UVicFormulaMotorsport/PDU/README.md

# PDU

The UVic Formula Motorsports Power Distribution Unit (PDU) replaces traditional
fuses and relays with solid state drivers switched and monitored by a
microcontroller. The PDU is intended to distribute power to all of the car's
electrical systems.
