UVicFormulaMotorsport/PDU/hardware/design/PDU-UV17.PcbDoc.htm

Reporting Options

# File in Previous Format

Date | : | 2021-09-23
Time | : | 09:46:36 AM
Filename | : | C:\Users\PC\Documents\GitHub\PDU\hardware\design\PDU-UV17.PcbDoc

Version | Warning

This file was generated by an earlier version of the software
