UVicFormulaMotorsport/PDU/hardware/release/UV17-B/PDU-Schematics-UV17-B.PDF

## Title Sheet

PDUv17: Power Distribution Unit | Revision: B
Date: 2017-02-21 | Sheet: 1/ 11

# PDUv17

# Power Distribution Unit

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
## Title.SchDoc Power.SchDoc Microcontroller.SchDoc Drivers - Low Current.SchDoc Drivers - High Current.SchDoc Multiplexers.SchDoc Serial IO.SchDoc Peripherals.SchDoc Inputs.SchDoc Connectors.SchDoc Mecahnical.SchDoc

## Fancy title sheet Power supplies AT90CAN automotive microcontroller Low current high side drivers High current high side drivers Analog multiplexers Serial IO expanders Peripherals: CAN, temperature sensors Digital and analog inputs Connectors Mechanical components and details

File Name | Page | Description
Revision | Date | Remarks

A
B

2017-02-17
2017-02-21

## Initial revision Added digital input pull-ups, analog and digital input clamping diodes

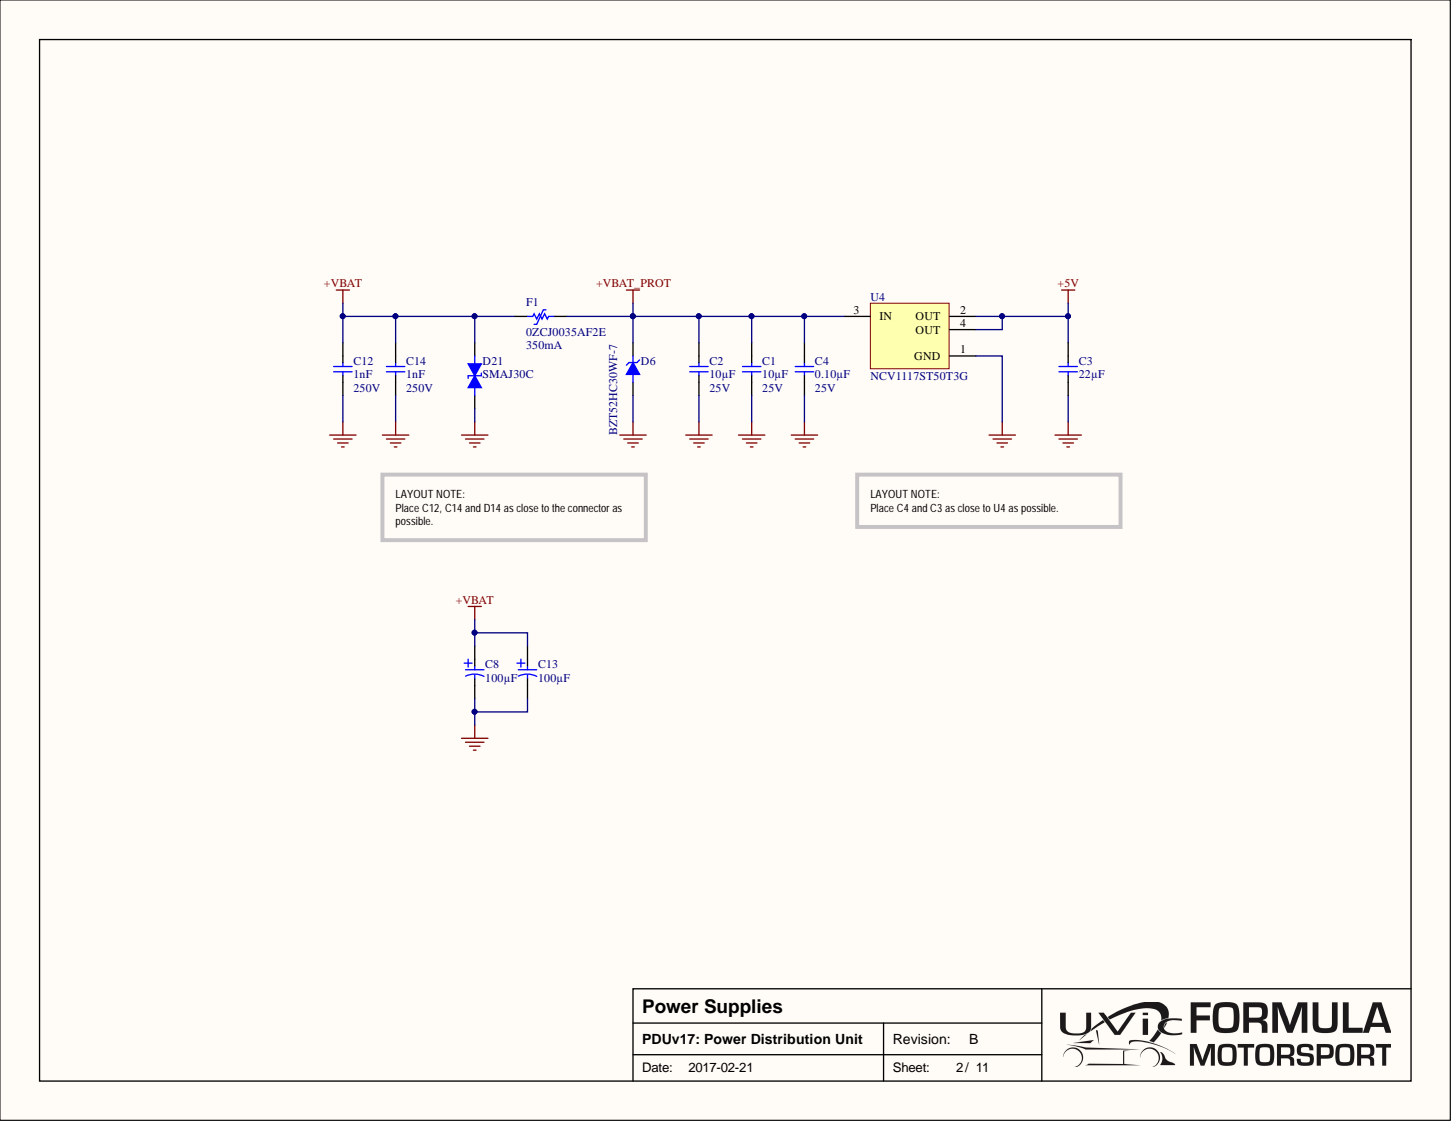
[picture p1: page 2]

LAYOUT NOTE:
Place C12, C14 and D14 as close to the connector as
possible.

Place C4 and C3 as close to U4 as possible.

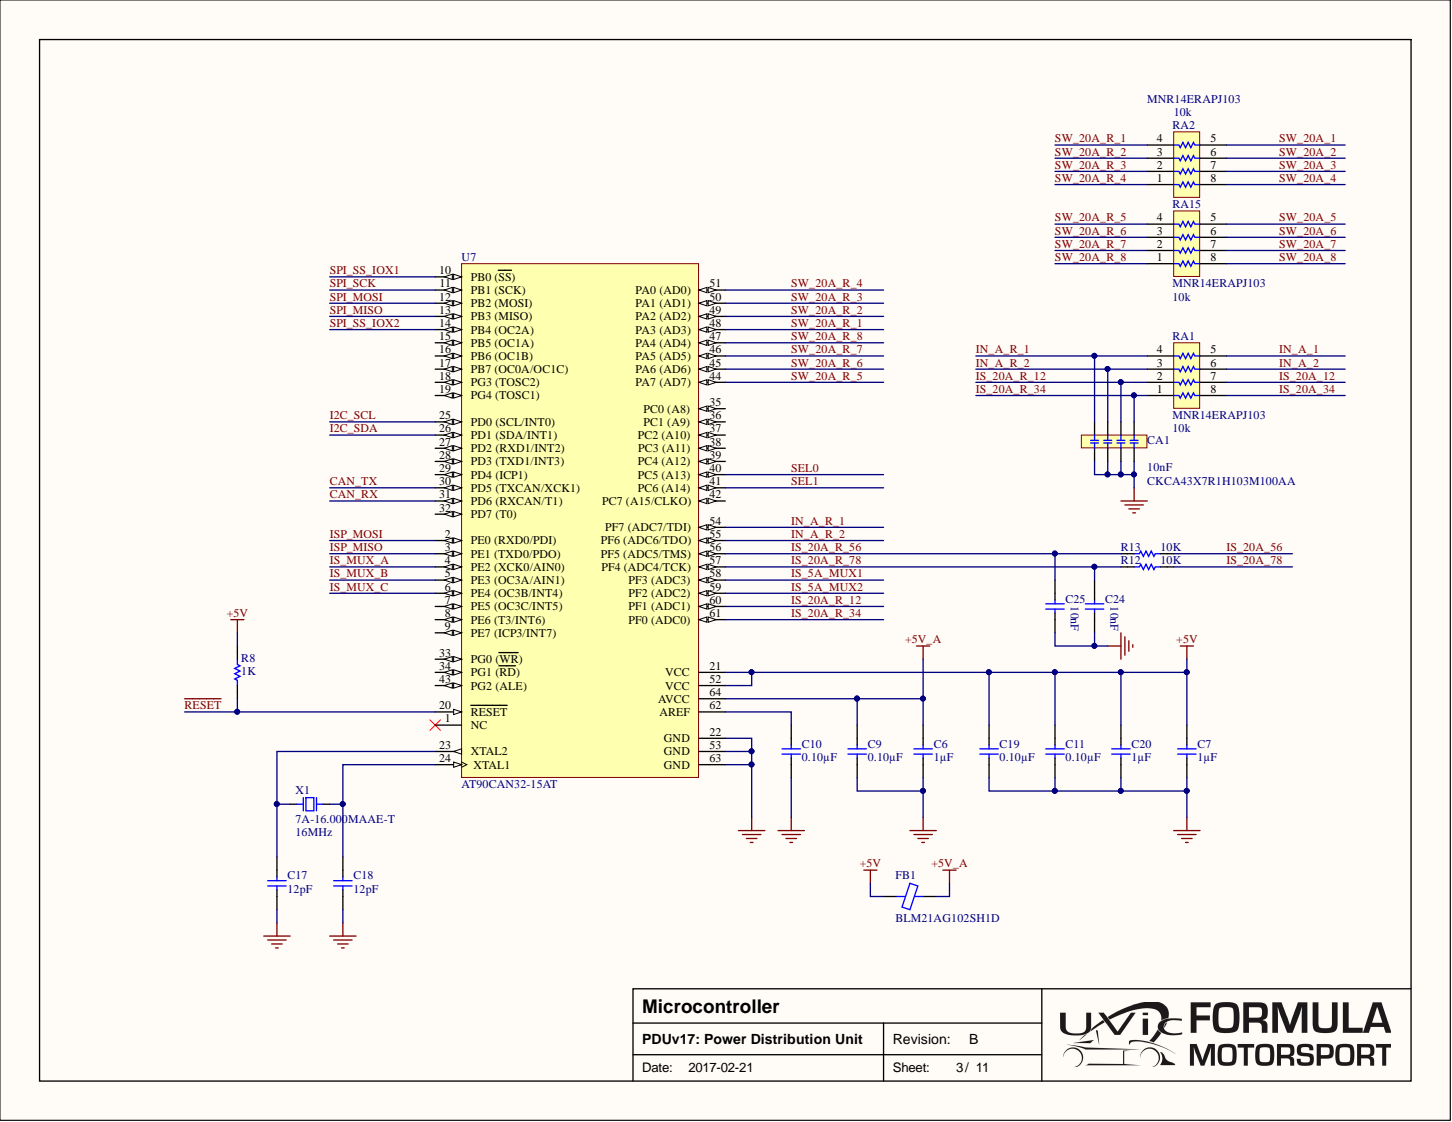
[picture p2: page 3]

2 2
5 3

u tio n Unit | Revision: B

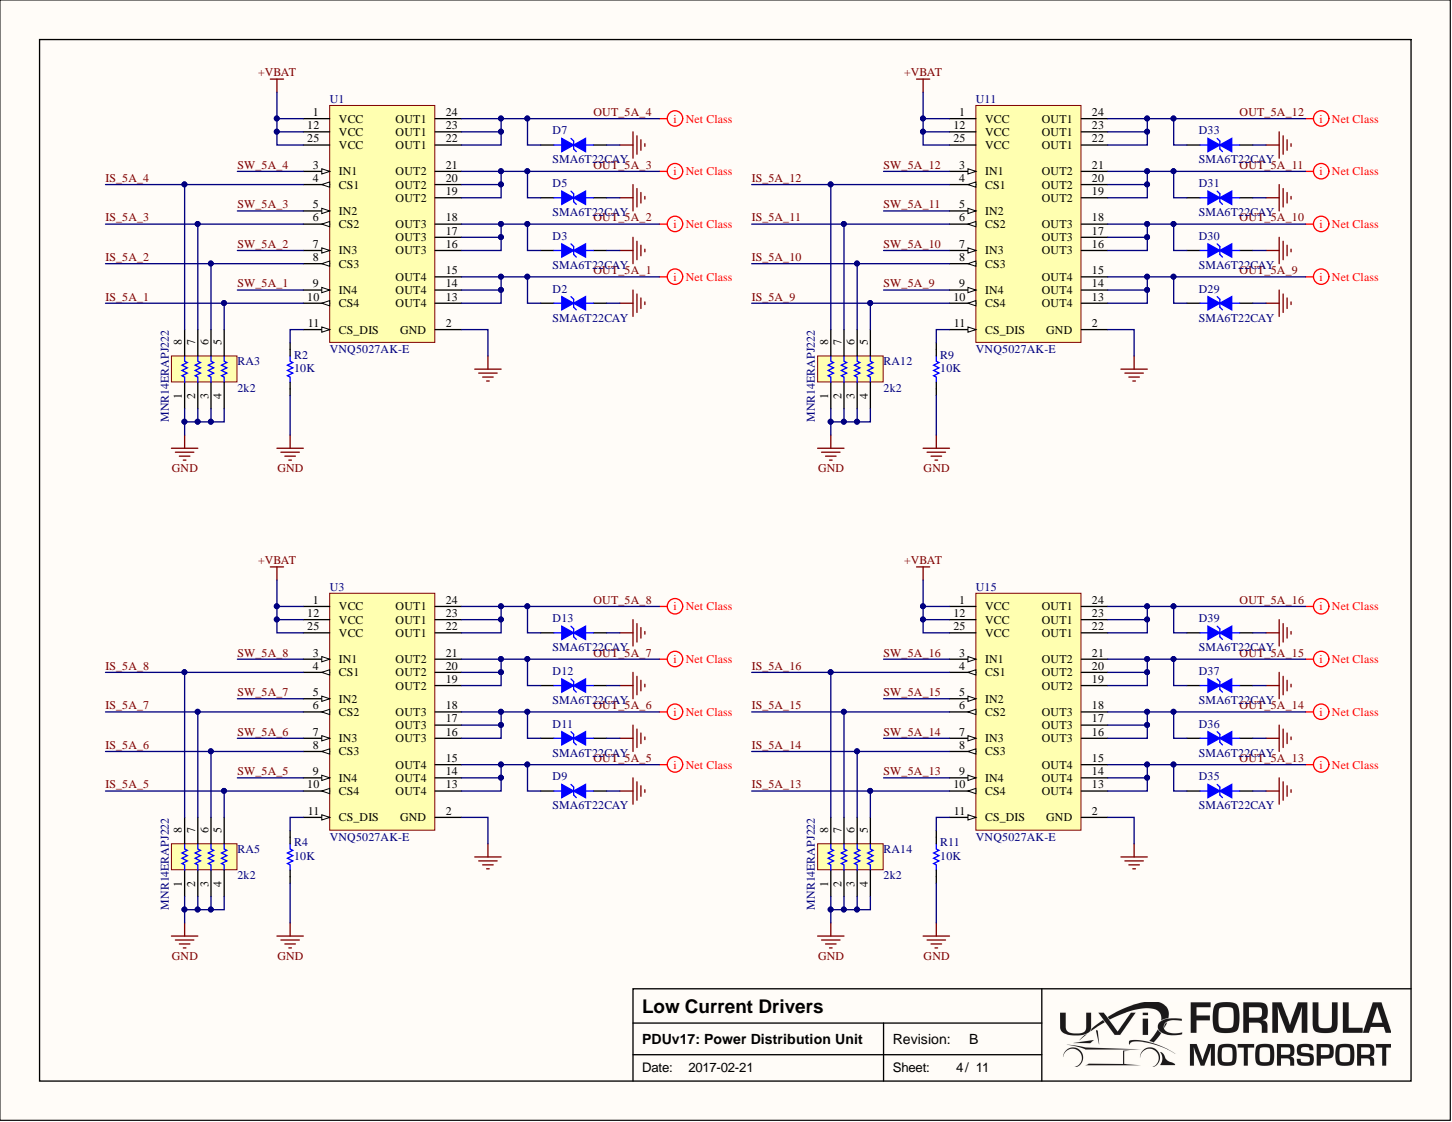
[picture p3: page 4]

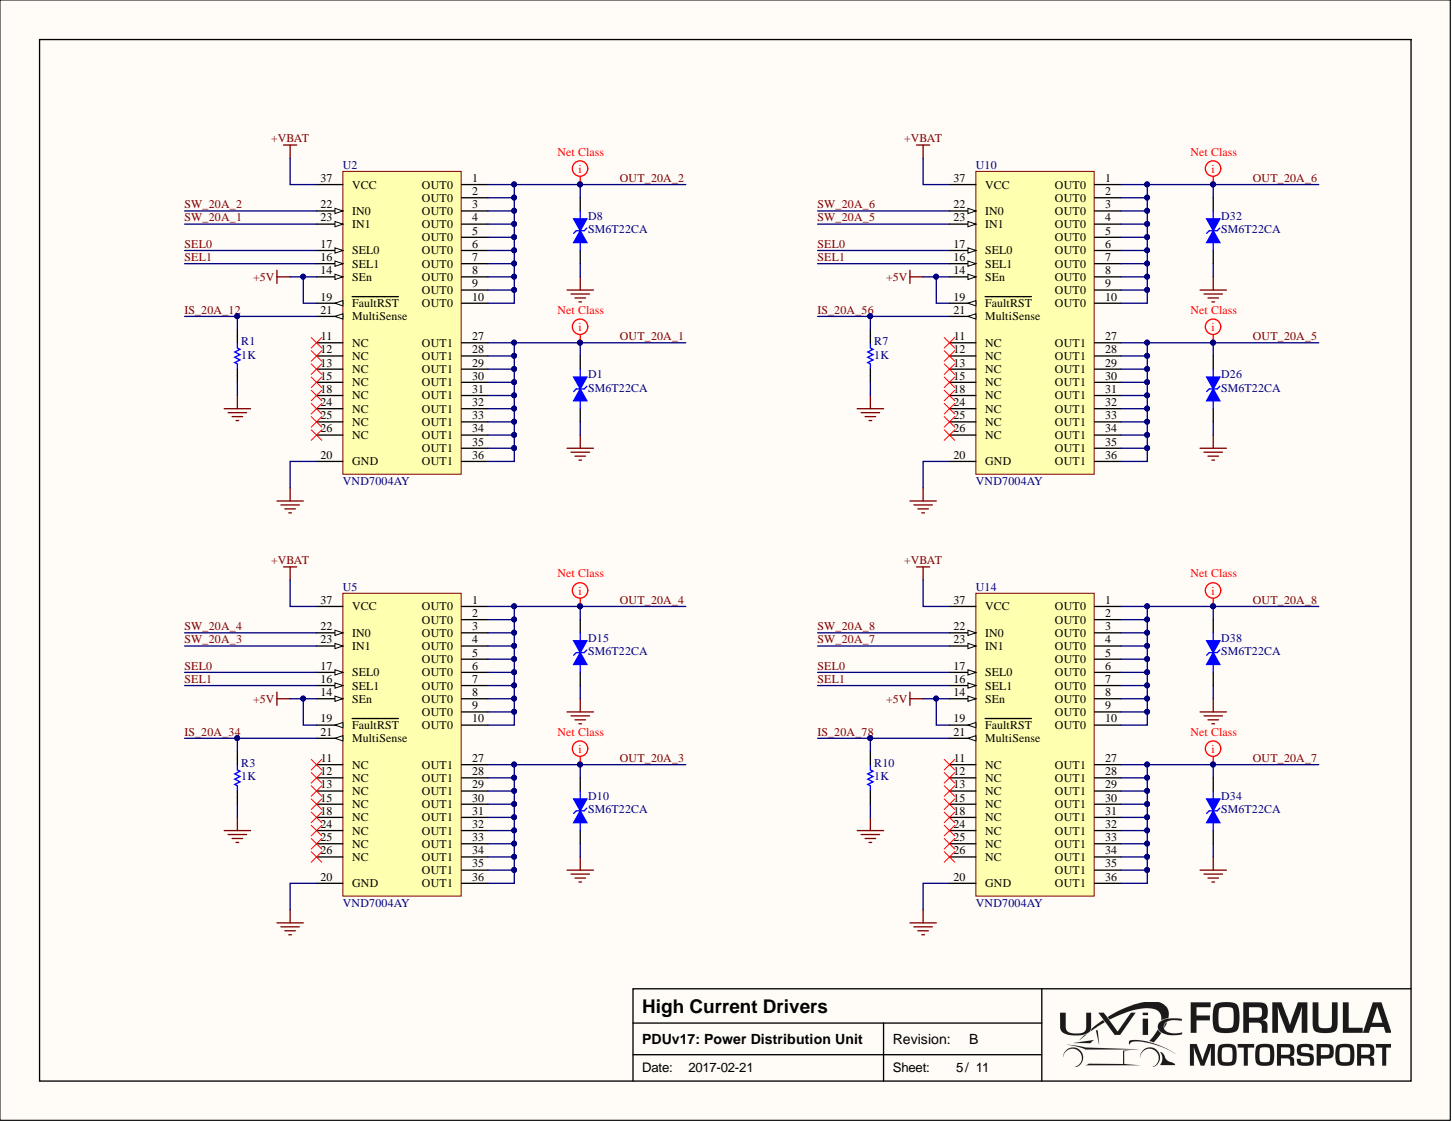
[picture p4: page 5]

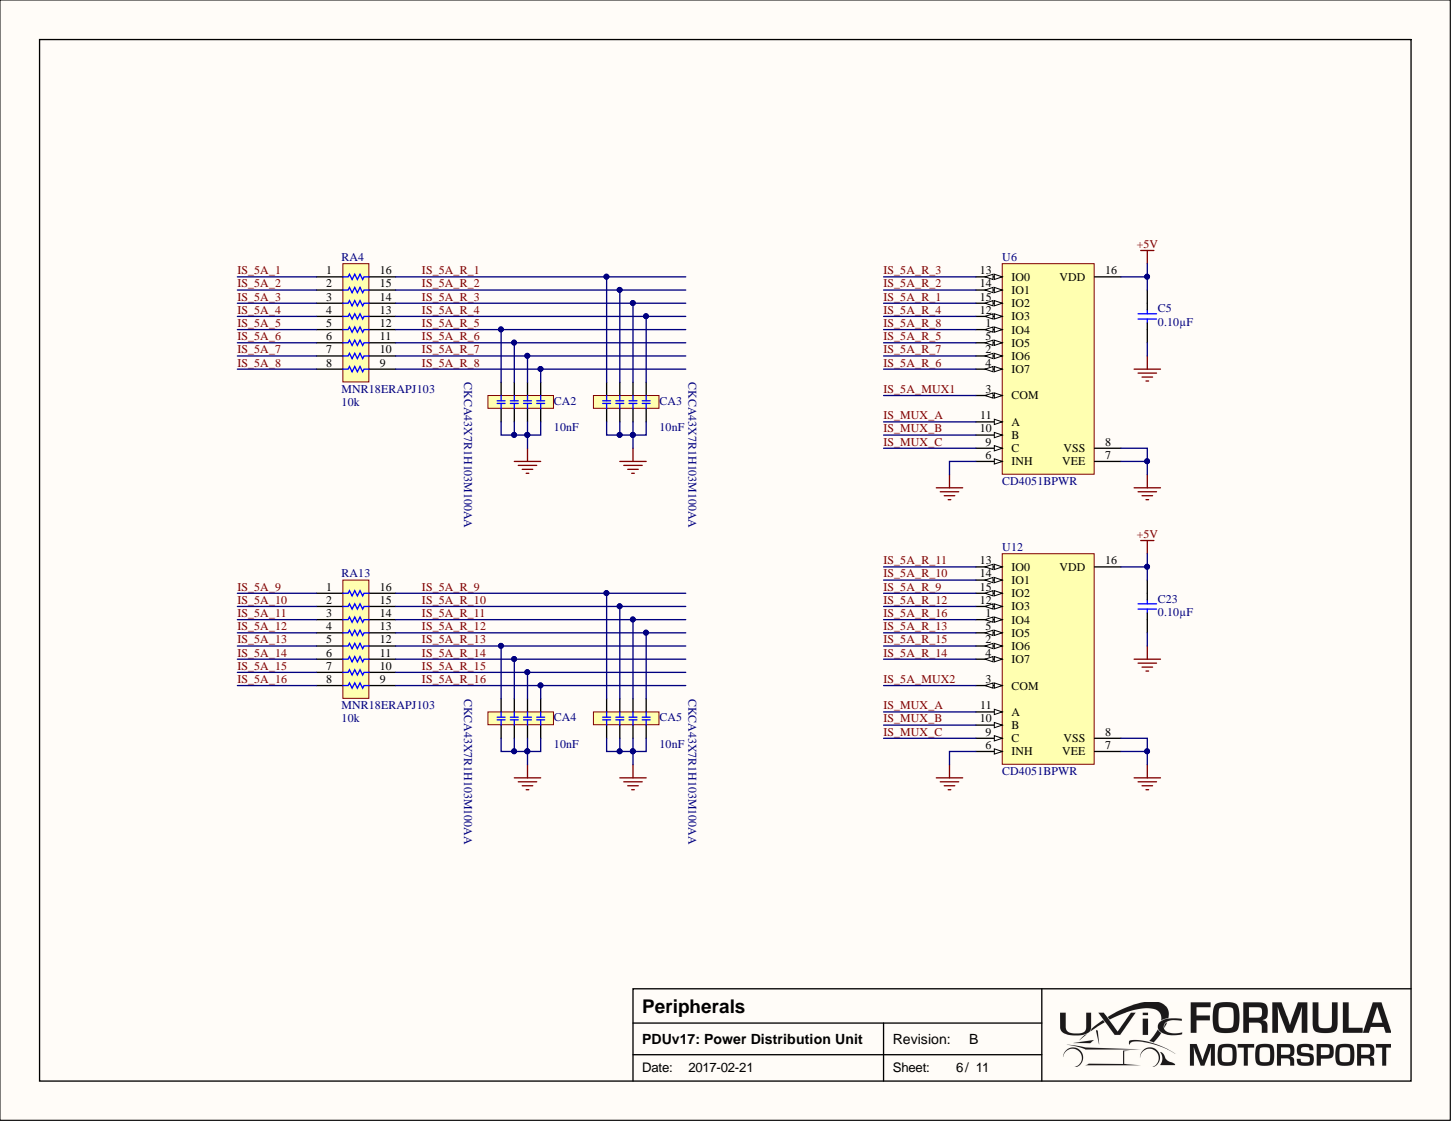
[picture p5: page 6]

rib u tio n Unit

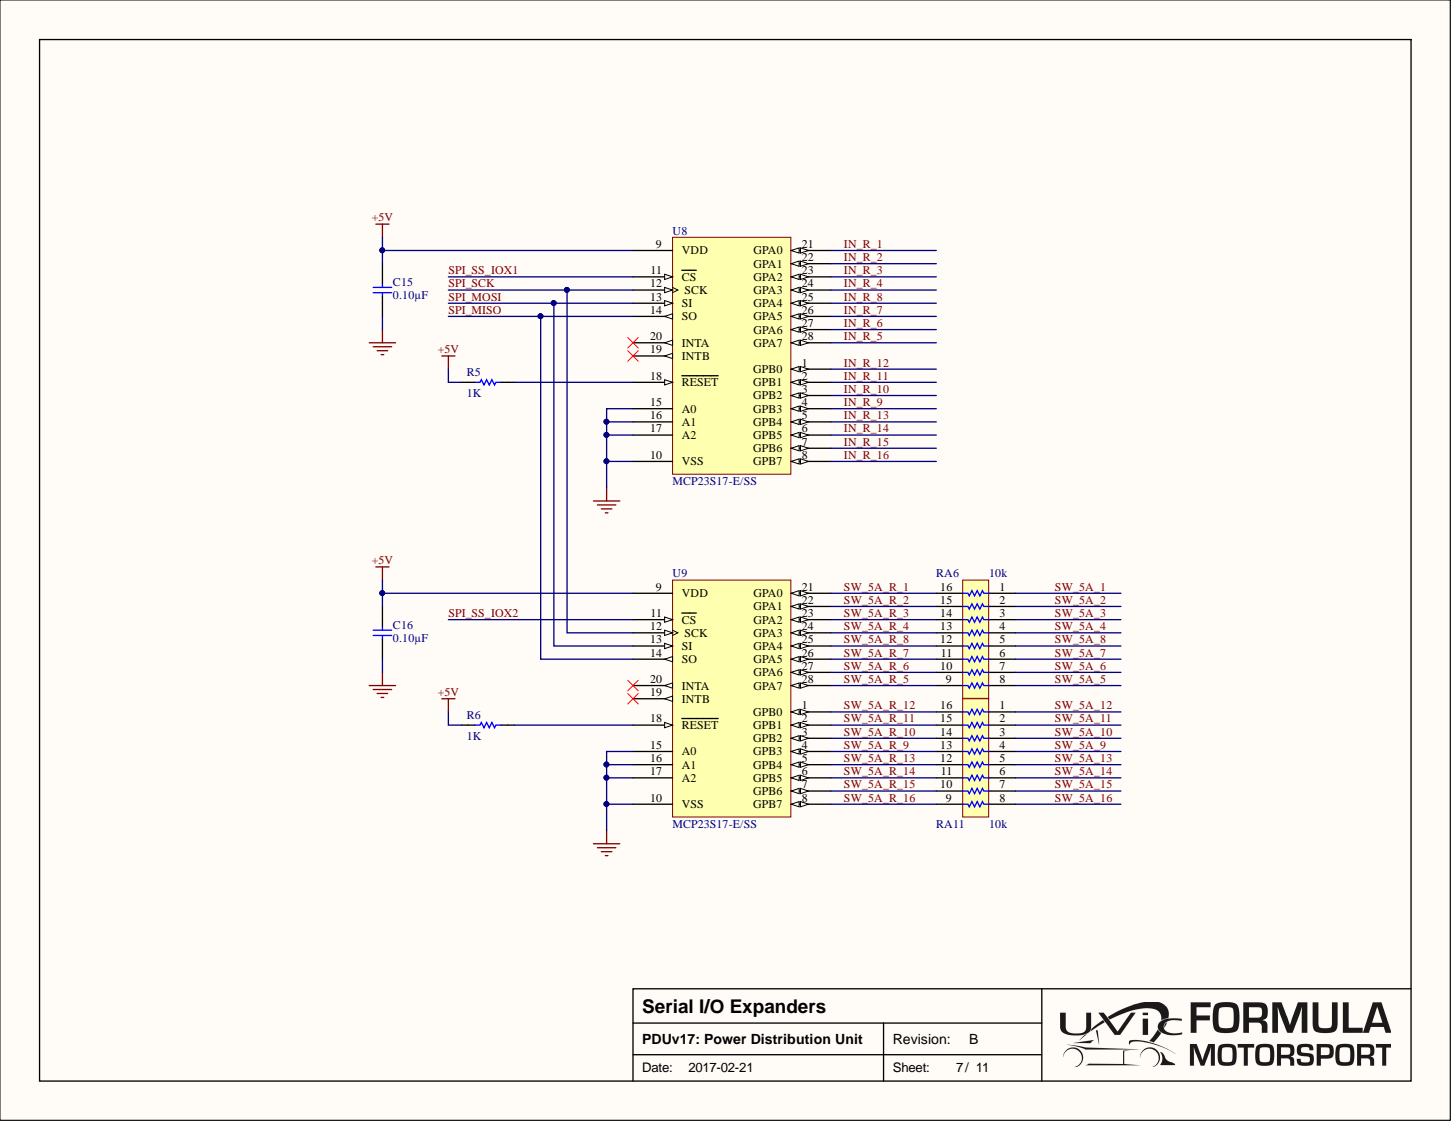
[picture p6: page 7]

1 6
1 7

1 2 | 2 4 SW _ 5 A _R_ 4 1 3
1 3 | 2 5 SW _ 5 A _R_ 8 1 2
1 4 | 2 6 SW _ 5 A _R_ 7 1 1

1 6 | 5 SW _ 5 A _R_ 1 3 1 2
1 7 | 6 SW _ 5 A _R_ 1 4 1 1
1 0 | 7 SW _ 5 A _R_ 1 5 1 0

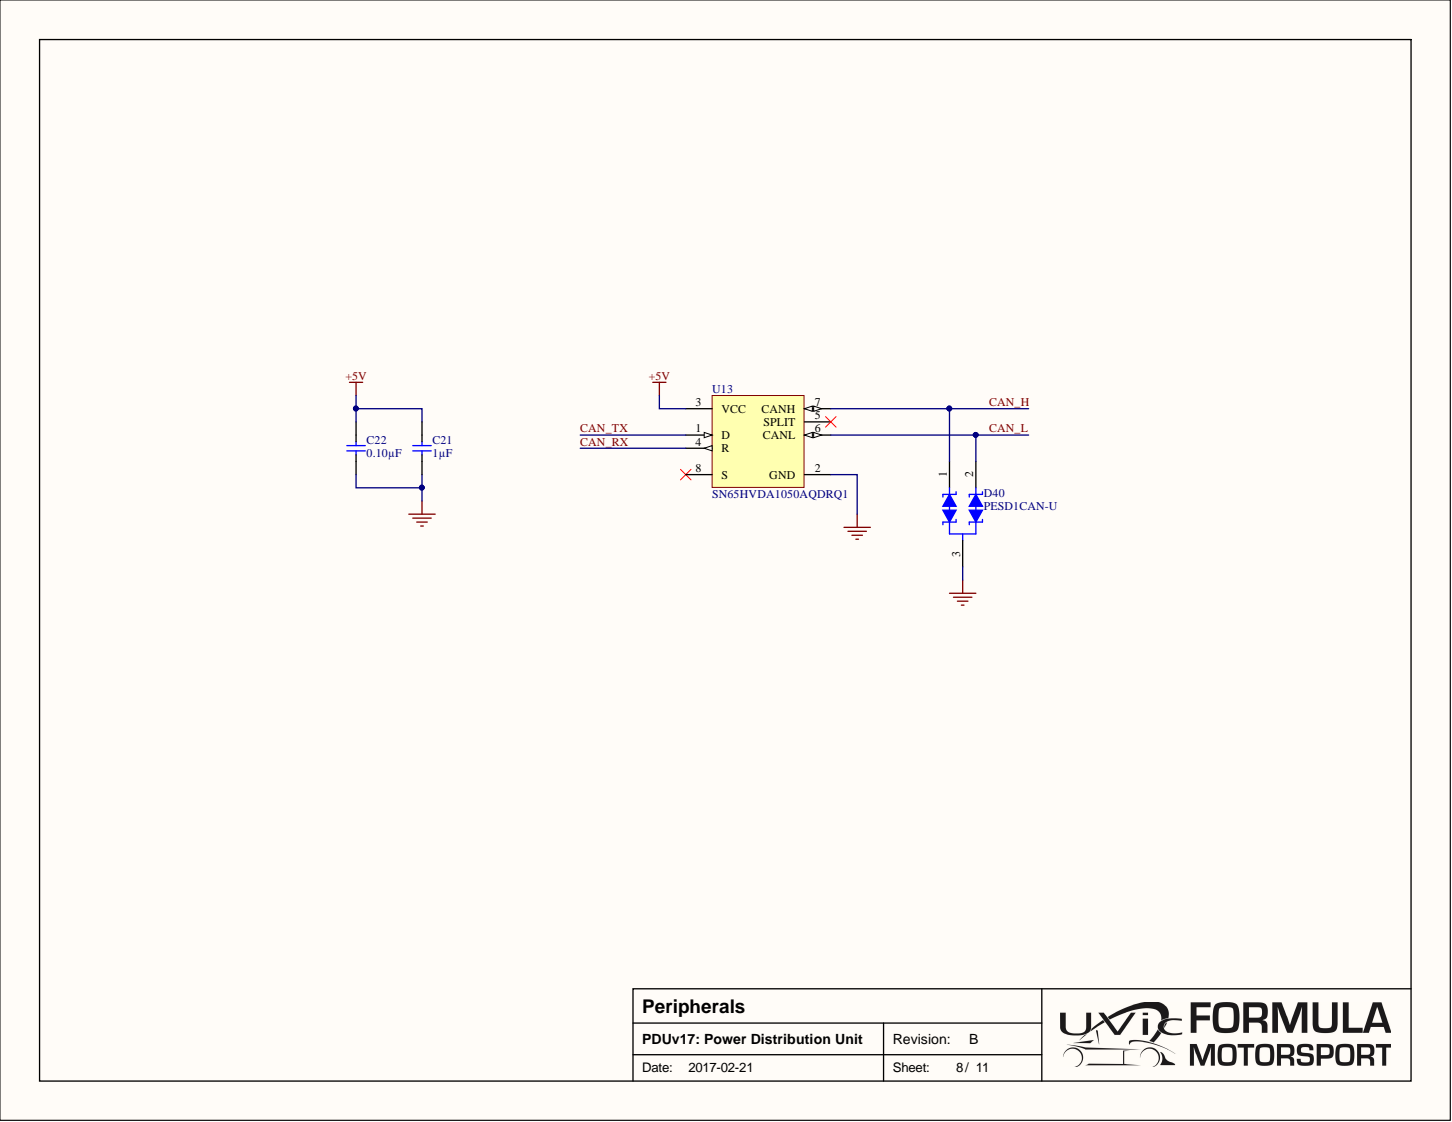
[picture p7: page 8]

rib u tio n Unit

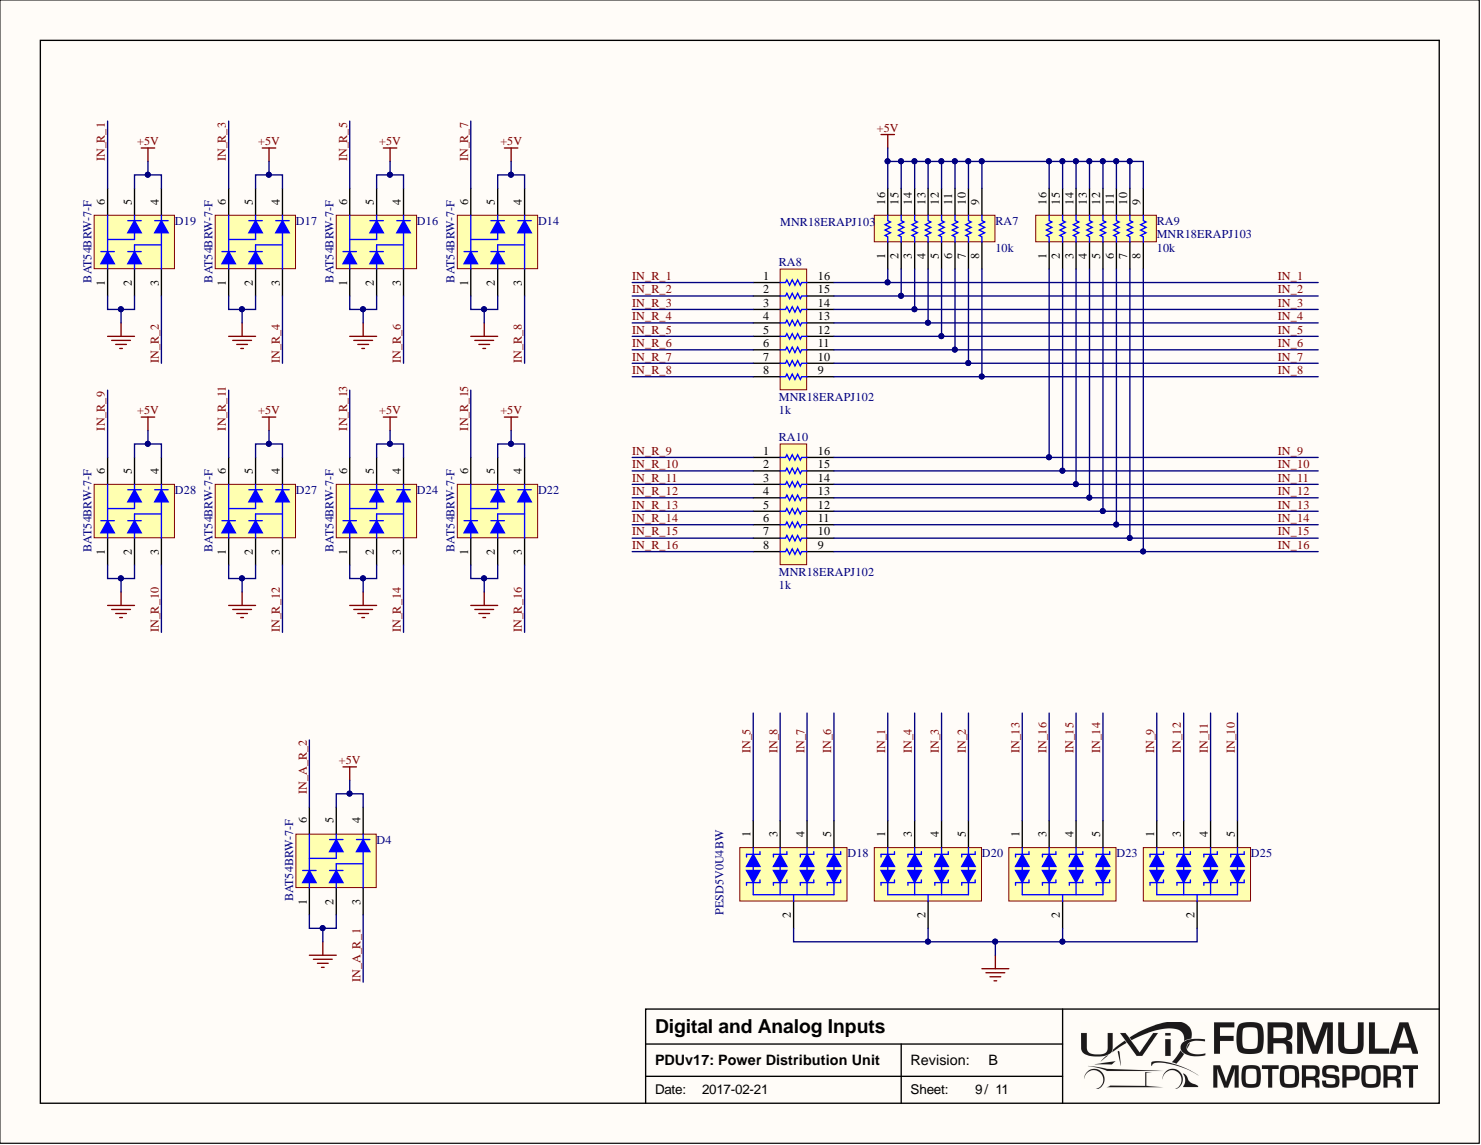
[picture p8: page 9]

Digital and Analog Inputs

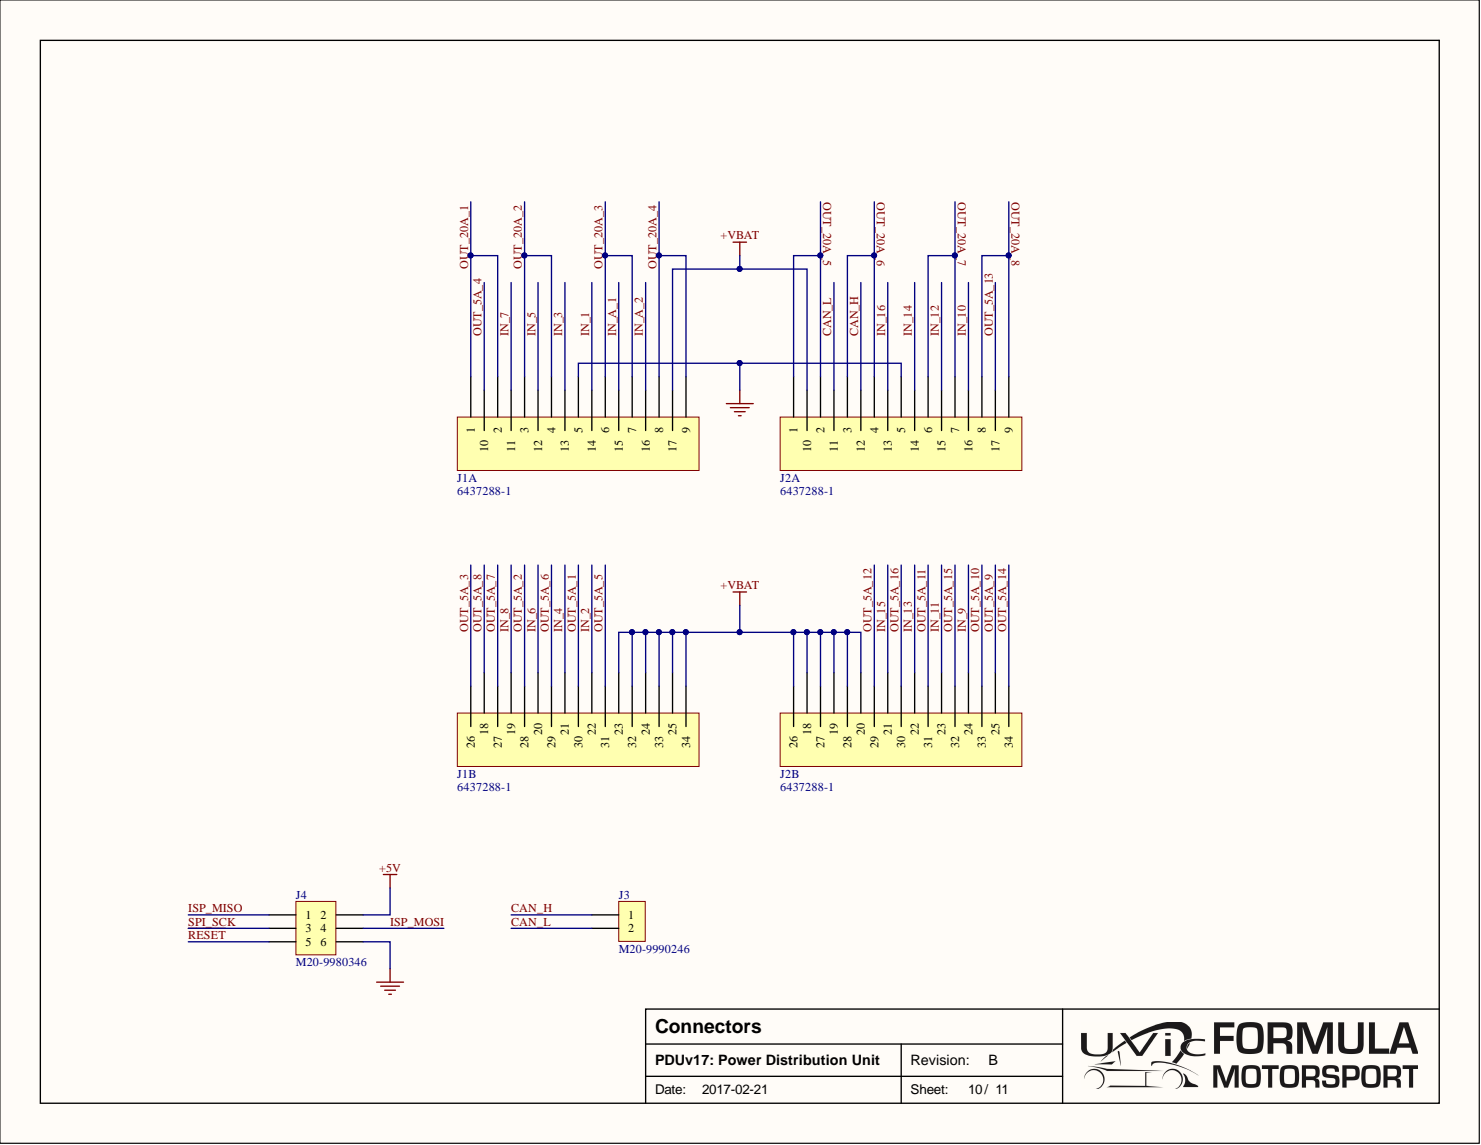
[picture p9: page 10]

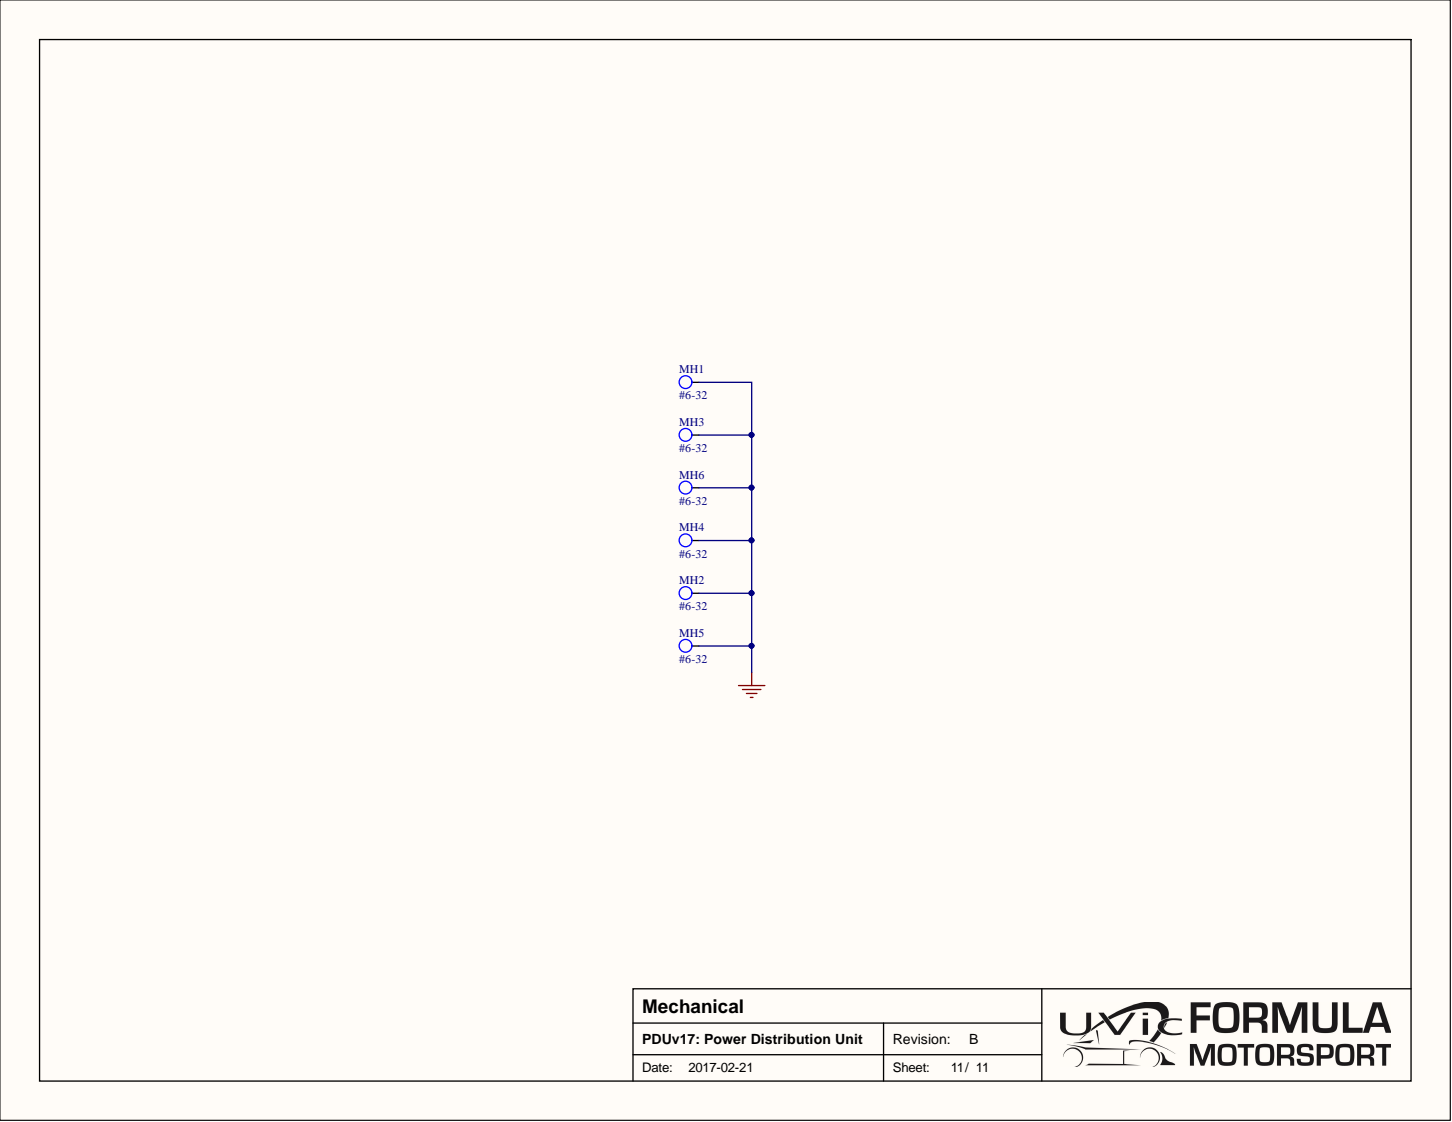
[picture p10: page 11]
