UVicFormulaMotorsport/PDU/(list of files, drawings)

Other design files:
hardware/design/Connectors.SchDoc
hardware/design/Drivers - High Current.SchDoc
hardware/design/Drivers - Low Current.SchDoc
hardware/design/Inputs.SchDoc
hardware/design/Mechanical.SchDoc
hardware/design/Microcontroller.SchDoc
hardware/design/Multiplexers.SchDoc
hardware/design/PDU-UV17.PcbLib
hardware/design/PDU-UV17.PrjPcb
hardware/design/PDU-UV17.SchLib
hardware/design/Peripherals.SchDoc
hardware/design/Power.SchDoc
hardware/design/Serial IO.SchDoc
hardware/design/Title.SchDoc
