UVicFormulaMotorsport/PDU/(commit log)

2017-02-20 Add UV17 revision A hardware design
    [Bill of Materials-PDU-UV17.csv, Connectors.SchDoc, Drivers - High Current.SchDoc, Drivers - Low Current.SchDoc, Mechanical.SchDoc, Microcontroller.SchDoc, Multiplexers.SchDoc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]
2017-02-22 Update hardware to UV17 revision B
    [Bill of Materials-PDU-UV17.csv, Connectors.SchDoc, Drivers - High Current.SchDoc, Drivers - Low Current.SchDoc, Inputs.SchDoc, Mechanical.SchDoc, Microcontroller.SchDoc, Multiplexers.SchDoc]
2017-02-22 Update silk layers to revision B
    [PDU-UV17.GBO, PDU-UV17.GTO]
2017-08-18 NDwatts remove initial bugs
    [pdu.c, pdu.h, pdu_can.c]
2017-08-22 NDwatts fix bitwise logic in PDU_channel_enabled()
    [pdu.c, pdu_can.c]
2021-09-26 Found correct pins for actuating electric shifter
    [pdu.c, pdu.h, pdu_can.c]
